Floo/RaspiDAC/Design/Frontplatte_5_Druckvorlage.pdf

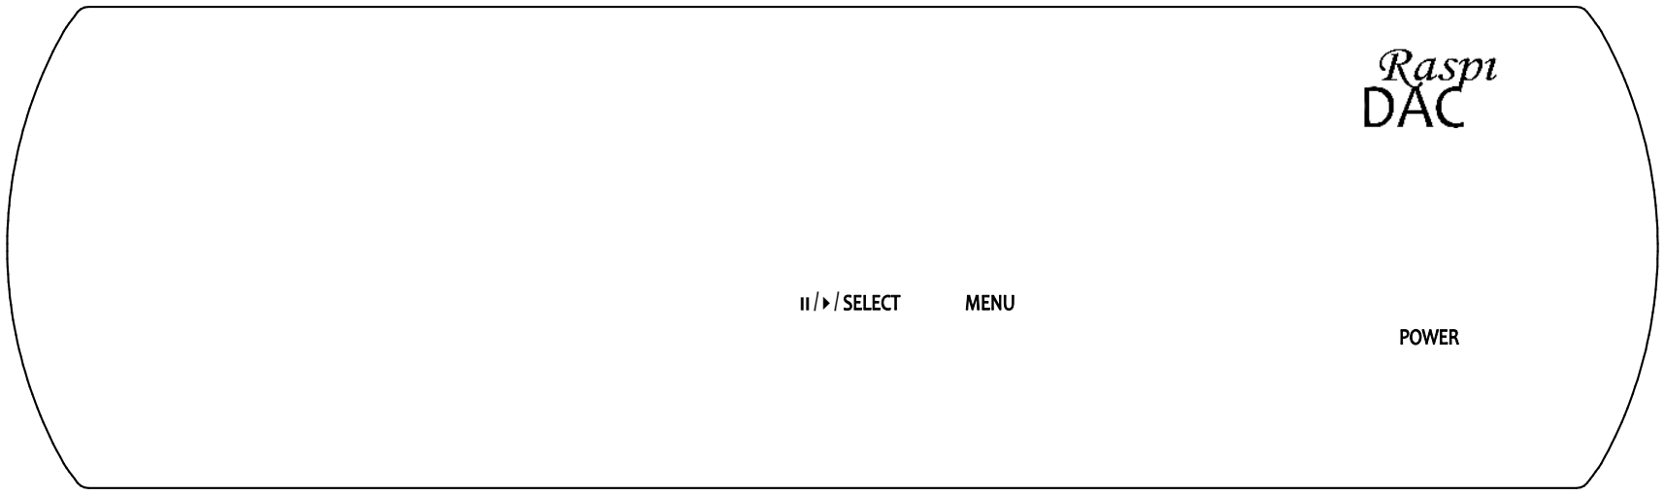
[picture p1: figure]
// SELECT; MENU; POWER
