Floo/RaspiDAC/Design/Rueckplatte_1_Druckvorlage.pdf

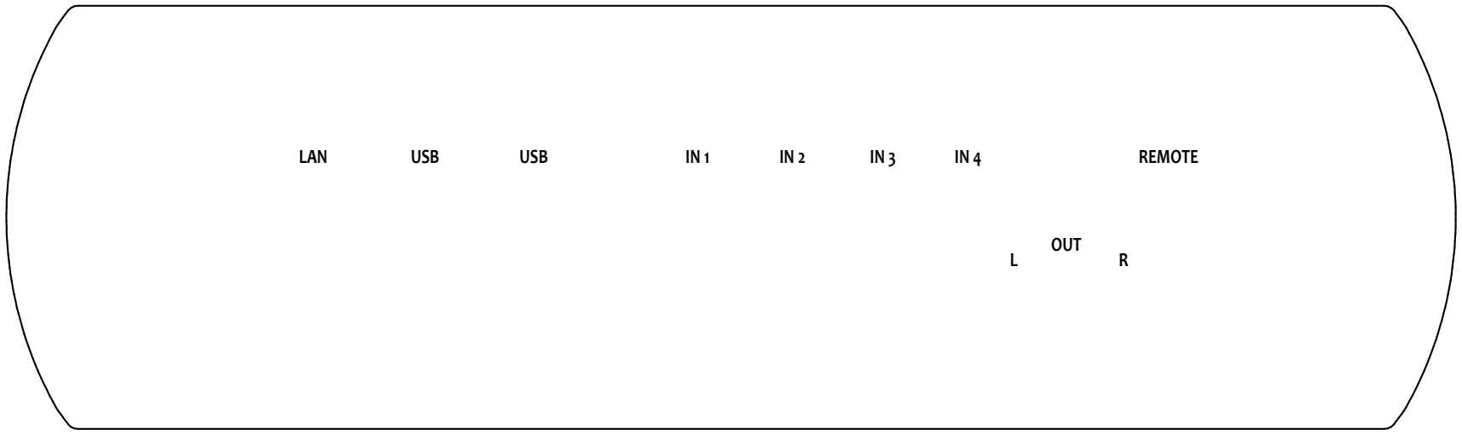
[picture p2: figure]
OUT; LAN; USB; REMOTE
