Floo/RaspiDAC/eagle/main_bom_v2.0.xlsx

Sheet: Tabelle1
Anzahl | Part | Value | Package | Lieferant | Best.-Nr. | Preis | Preis pro Einheit
4 | C11, C14, C19, C20 | 1n NP0 | 0805 | Segor | 1n0-0805-NP0 | 0.05 € | 0.20 €
7 | C5, C6, C10, C22, C23, C24, C25 | 10n | 0805 | Segor | 10n-0805-X7R | 0.05 € | 0.35 €
1 | C21 | 22n X7R | 0805 | Segor | 22n-0805-X7R | 0.05 € | 0.05 €
13 | C1, C2, C3, C7, C12, C15, C18, C26, C27, C28, C29, C30, C31 | 100n | 0805 | Segor | 100n-0805-X7R | 0.05 € | 0.65 €
4 | C9, C13, C16, C17 | 10µ | 3216 | Conrad | 458293 | 0.30 € | 1.20 €
2 | C4, C8 | 47µ/10V | 3528 | Conrad | 458307 (https://www.reichelt.de/Elkos-radial-105-C-1000-5000h/RAD-FC-10-50/3/index.html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) | 0.31 € | 0.62 €
2 | L1, L2 | 47µH | 1210 | Reichelt | LQH3C 47µ | 0.14 € | 0.28 €
1 | L3 | LPS4012-103 (10µH) |  | Coilcraft | Sample | 0.00 € | 0.00 €
3 | R20, R21, R22 | 1R | 0805 | Segor | 1R0-0805-1% | 0.04 € | 0.11 €
2 | R23, R24 | 75R | 0805 | Segor | 75R-0805-1% | 0.04 € | 0.08 €
3 | R7, R10, R11 | 100R | 0805 | Segor | 100R-0805-1% | 0.04 € | 0.11 €
1 | R19 | 3k | 0805 | Segor | 3k0-0805-1% | 0.04 € | 0.04 €
1 | R5 | 4k7 | 0805 | Segor | 4k7-0805-1% | 0.04 € | 0.04 €
14 | R1, R2, R12, R13, R14, R15, R16, R17, R25, R26, R27, R28, R29, R30 | 10k | 0805 | Segor | 10k-0805-1% | 0.04 € | 0.53 €
3 | R3, R8, R9 | 22k | 0805 | Segor | 22k-0805-1% | 0.04 € | 0.11 €
3 | R4, R6, R18 | 47k | 0805 | Segor | 47k-0805-1% | 0.04 € | 0.11 €
5 | T1, T3, T4, T5, T7 | BC847 | SOT23 | Reichelt | BC 847C SMD | 0.04 € | 0.20 €
2 | T2, T6 | BC857 | SOT23 | Reichelt | BC 857C SMD | 0.04 € | 0.08 €
2 | U1, U2 | DA101 |  | Segor | DA101C | 3.20 € | 6.40 €
3 | X3, X4, X5 | Cinch-Buchse |  | Conrad | 736899 | 1.47 € | 4.41 €
1 | IC1 | 74CBTLV3257 | SO-16 | vorhanden |  | 0.00 € | 0.00 €
1 | IC2 | PCA9530 | SO-8 | Reichelt | PCA 9530 D | 1.45 € | 1.45 €
1 | IC4 | CS8416 | SO-28 | Cirrus | Sample | 0.00 € | 0.00 €
1 | IC3 | RAC04-05SC/230 |  | Recom | Sample | 0.00 € | 0.00 €
1 | IC6 | MAX1836EUT33 | SOT23-6 | Maxim | Sample | 0.00 € | 0.00 €
1 | IC5 | MCP130-300 | SOT23 | Conrad | 1085790 | 0.65 € | 0.65 €
1 | K1 | G6A 5V |  | Conrad | 503801 | 4.20 € | 4.20 €
2 | OX1, OX2 | TORX1952 |  | vorhanden |  | 7.30 € | 14.60 €
6 | D1, D2, D3, D4, D5, D6 | BAS16 | SOT23 | Conrad | 162030 | 0.07 € | 0.42 €
1 | D7 | BAT165 | SOD323 | Conrad | 152958 | 0.21 € | 0.21 €
1 | F1 | MIK-TRÄGE 0,1A |  | Reichelt | MIK-TRÄGE 0,1A | 0.32 € | 0.32 € | höherer Wert wegen Einschaltstrom
2 |  | Pfostenverbinder RM2,54 2x13 |  | Conrad | 742185 | 0.56 € | 1.12 €
2 |  | Pfostenverbinder RM2,54 2x20 |  | Conrad | 742221 | 0.74 € | 1.48 €
1 |  | OS-0038N |  | Conrad | 184301 | 0.99 € | 0.99 €
 |  |  |  |  |  |  | 41.02 €

Sheet: main_bom
Part | Value | Device | Package | Description | MF MPN OC_FARNELL OC_NEWARK
C1 | 100n | C-EUC0805 | C0805 | CAPACITOR, European symbol
C2 | 100n | C-EUC0805 | C0805 | CAPACITOR, European symbol
C3 | 100n | C-EUC0805 | C0805 | CAPACITOR, European symbol
C4 | 47µ | CPOL-EUE2-4 | E2-4 | POLARIZED CAPACITOR, European | symbol
C5 | 10n | C-EUC0805 | C0805 | CAPACITOR, European symbol
C6 | 10n | C-EUC0805 | C0805 | CAPACITOR, European symbol
C7 | 100n | C-EUC0805 | C0805 | CAPACITOR, European symbol
C8 | 100µ | CPOL-EUE2-4 | E2-4 | POLARIZED CAPACITOR, European | symbol
C9 | 10µ | CPOL-EUE2-4 | E2-4 | POLARIZED CAPACITOR, European | symbol
C10 | 10n | C-EUC0805 | C0805 | CAPACITOR, European symbol
C11 | 1n | C-EUC0805 | C0805 | CAPACITOR, European symbol
C12 | 100n | C-EUC0805 | C0805 | CAPACITOR, European symbol
C13 | 10µ | CPOL-EUE2-4 | E2-4 | POLARIZED CAPACITOR, European | symbol
C14 | 1n | C-EUC0805 | C0805 | CAPACITOR, European symbol
C15 | 100n | C-EUC0805 | C0805 | CAPACITOR, European symbol
C16 | 10µ | CPOL-EUE2-4 | E2-4 | POLARIZED CAPACITOR, European | symbol
C17 | 10µ | CPOL-EUE2-4 | E2-4 | POLARIZED CAPACITOR, European | symbol
C18 | 100n | C-EUC0805 | C0805 | CAPACITOR, European symbol
C19 | 1n | C-EUC0805 | C0805 | CAPACITOR, European symbol
C20 | 1n | C-EUC0805 | C0805 | CAPACITOR, European symbol
C21 | 22n | C-EUC0805 | C0805 | CAPACITOR, European symbol
C22 | 10n | C-EUC0805 | C0805 | CAPACITOR, European symbol
C23 | 10n | C-EUC0805 | C0805 | CAPACITOR, European symbol
C24 | 10n | C-EUC0805 | C0805 | CAPACITOR, European symbol
C25 | 10n | C-EUC0805 | C0805 | CAPACITOR, European symbol
C26 | 100n | C-EUC0805 | C0805 | CAPACITOR, European symbol
C27 | 100n | C-EUC0805 | C0805 | CAPACITOR, European symbol
C28 | 100n | C-EUC0805 | C0805 | CAPACITOR, European symbol
C29 | 100n | C-EUC0805 | C0805 | CAPACITOR, European symbol
C30 | 100n | C-EUC0805 | C0805 | CAPACITOR, European symbol
CON1 |  | CON40 | CON40 | CONNECTOR | unknown unknown
CON2 |  | CON26 | CON26 | CONNECTOR | unknown unknown
D1 | BAS40 | BAS40 | SOT23 | Silicon Schottky Diodes
D2 | BAS40 | BAS40 | SOT23 | Silicon Schottky Diodes
D3 | BAS40 | BAS40 | SOT23 | Silicon Schottky Diodes
D4 | BAS40 | BAS40 | SOT23 | Silicon Schottky Diodes
D5 | BAS40 | BAS40 | SOT23 | Silicon Schottky Diodes
F1 |  | 19560 | 19560 | FUSE HOLDER | 56000001009 1185363 15P8392
IC1 | 74HC2 | 57D 74HC257D | SO16 | Quadruple 2-to 1 line data SE | LECTOR/MULTIPLEXER
IC2 | PCA95 | 30 PCA9530 | SOIC-8
IC3 | RAC04 | RAC04 | RECOM-RAC04
IC4 | CS841 | 6-SOFTWAREMODESOFTWAREMODE CS8416-SOFTWAREMODESOFTWAREMODE | SO28L | 24bit 192kHz Digital Audio In | terface Receiver - Software Mode
IC5 | MCP13 | 0-300I/SN MCP130-300I/SN | SOT-23
IC6 | REG11 | 17 REG1117 | SOT223 | 800mA and 1A Low Dropout (LDO | ) Positive Regulator REG1117 1097566 14P6981
JP1 |  | PINHD-2X3 | 2X03 | PIN HEADER
JP2 |  | PINHD-2X3 | 2X03 | PIN HEADER
JP3 |  | PINHD-2X3 | 2X03 | PIN HEADER
JP4 |  | JP1Q | JP1 | JUMPER
K1 | G6A-2 | 34P G6A-234P | G6A-234P | RELAY | unknown unknown
L1 | 47µ | L-EU | C1210 | INDUCTOR, European symbol
L2 | 47µ | L-EU | C1210 | INDUCTOR, European symbol
OX1 | TORX1 | 73 TORX173 | TORX173 | FIBER OPTIC RECEIVING MODULE | unknown unknown
OX2 | TORX1 | 73 TORX173 | TORX173 | FIBER OPTIC RECEIVING MODULE | unknown unknown
R1 | 10k | R-EU_R0805 | R0805 | RESISTOR, European symbol
R2 | 10k | R-EU_R0805 | R0805 | RESISTOR, European symbol
R3 | 22k | R-EU_R0805 | R0805 | RESISTOR, European symbol
R4 | 47k | R-EU_R0805 | R0805 | RESISTOR, European symbol
R5 | 4k7 | R-EU_R0805 | R0805 | RESISTOR, European symbol
R6 | 47k | R-EU_R0805 | R0805 | RESISTOR, European symbol
R7 | 100R | R-EU_R0805 | R0805 | RESISTOR, European symbol
R8 | 22k | R-EU_R0805 | R0805 | RESISTOR, European symbol
R9 | 22k | R-EU_R0805 | R0805 | RESISTOR, European symbol
R10 | 100R | R-EU_R0805 | R0805 | RESISTOR, European symbol
R11 | 100R | R-EU_R0805 | R0805 | RESISTOR, European symbol
R12 | 10k | R-EU_R0805 | R0805 | RESISTOR, European symbol
R13 | 10k | R-EU_R0805 | R0805 | RESISTOR, European symbol
R14 | 10k | R-EU_R0805 | R0805 | RESISTOR, European symbol
R15 | 10k | R-EU_R0805 | R0805 | RESISTOR, European symbol
R16 | 10k | R-EU_R0805 | R0805 | RESISTOR, European symbol
R17 | 10k | R-EU_R0805 | R0805 | RESISTOR, European symbol
R18 | 47k | R-EU_R0805 | R0805 | RESISTOR, European symbol
R19 | 3k | R-EU_R0805 | R0805 | RESISTOR, European symbol
R20 | 1R | R-EU_R0805 | R0805 | RESISTOR, European symbol
R21 | 1R | R-EU_R0805 | R0805 | RESISTOR, European symbol
R22 | 1R | R-EU_R0805 | R0805 | RESISTOR, European symbol
R23 | 75R | R-EU_R0805 | R0805 | RESISTOR, European symbol
R24 | 75R | R-EU_R0805 | R0805 | RESISTOR, European symbol
R25 | 10k | R-EU_R0805 | R0805 | RESISTOR, European symbol
R26 | 10k | R-EU_R0805 | R0805 | RESISTOR, European symbol
R27 | 10k | R-EU_R0805 | R0805 | RESISTOR, European symbol
T1 | BC847 | BC847-NPN-SOT23-BEC | SOT23-BEC | NPN Transistror
T2 | BC857 | BC857A-PNP-SOT23-BEC | SOT23-BEC | PNP Transistror
T3 | BC847 | BC847-NPN-SOT23-BEC | SOT23-BEC | NPN Transistror
T4 | BC847 | BC847-NPN-SOT23-BEC | SOT23-BEC | NPN Transistror
T5 | BC847 | BC847-NPN-SOT23-BEC | SOT23-BEC | NPN Transistror
U$1 | DA101 | DA101 | 6PIN-DIL
U$2 | DA101 | DA101 | 6PIN-DIL
X1 |  | 2POL500 | 2POL500 | PHOENIX CONNECTOR | unknown unknown
X2 |  | 2POL500 | 2POL500 | PHOENIX CONNECTOR | unknown unknown
X3 | WBTOR | 1 WBTOR1 | WBTOR1 | RCA connectors according to J | EITA RC-5231 Cinch WBTOR 1 BLACK 1200146 98K2588
X4 | WBTOR | 1 WBTOR1 | WBTOR1 | RCA connectors according to J | EITA RC-5231 Cinch WBTOR 1 BLACK 1200146 98K2588
X5 | WBTOR | 1 WBTOR1 | WBTOR1 | RCA connectors according to J | EITA RC-5231 Cinch WBTOR 1 BLACK 1200146 98K2588
