Floo/RaspiDAC/Design/Frontplatte_5_bemasst.DXF

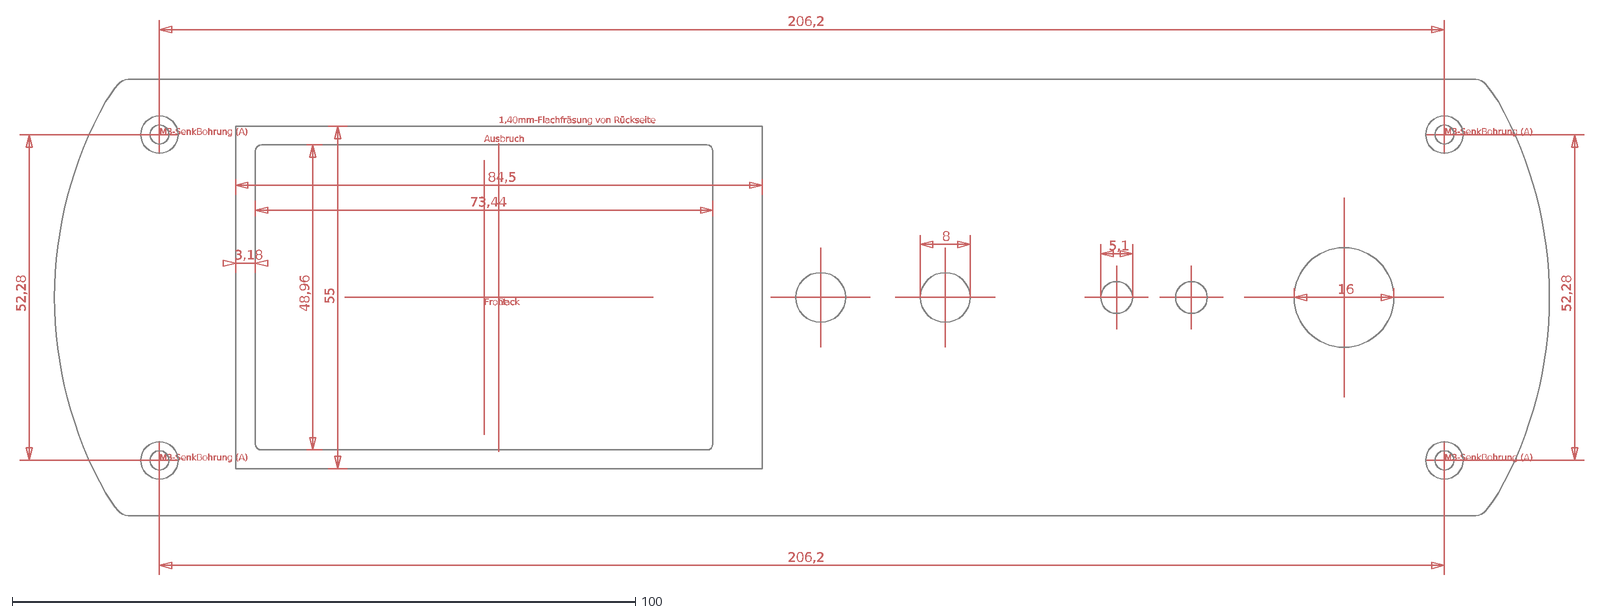
[picture p3: CAD file, 2015-07-29]
Design/Frontplatte_5_bemasst.DXF
M3-SenkBohrung (A)
Ausbruch
Front
1,40mm-Flachfräsung von Rückseite
Back
52,28
206,2
48,96
55
84,5
73,44
3,18
5,1
8
16
