Floo/RaspiDAC/Design/Frontplatte_5.DXF

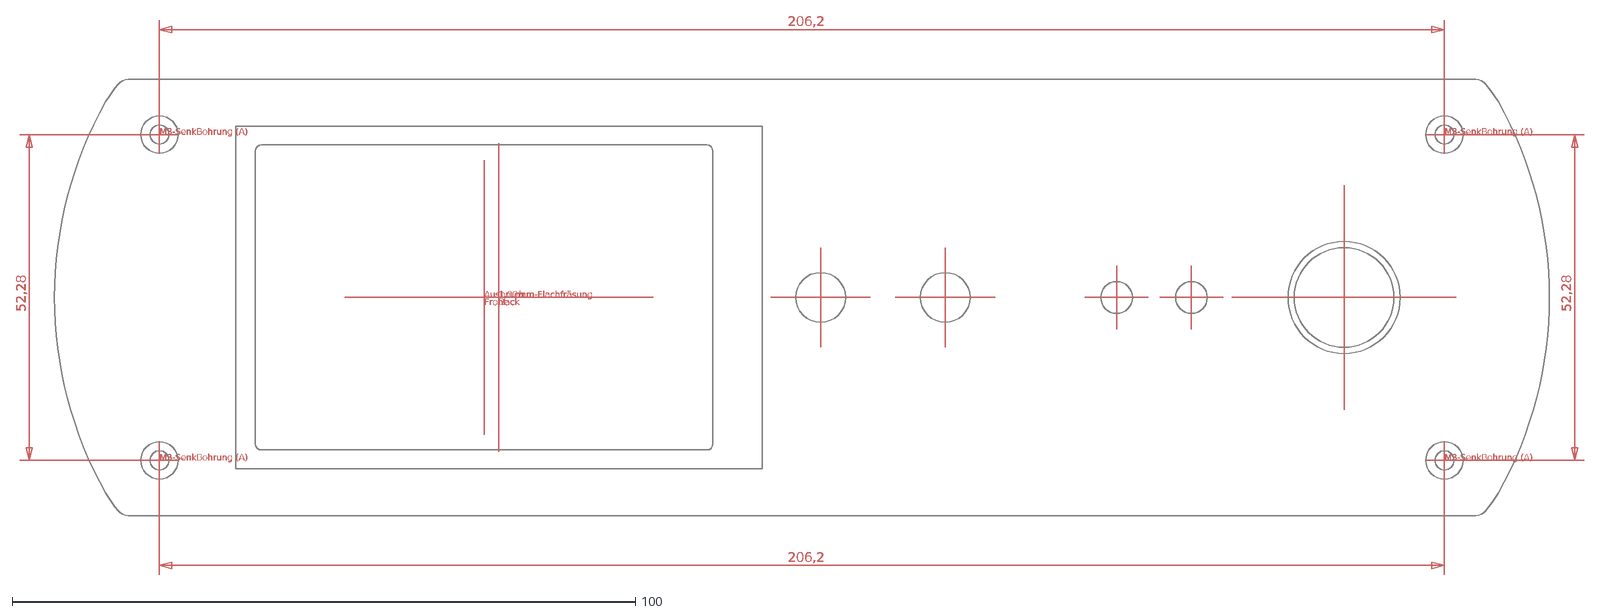
[picture p4: CAD file, 2015-07-15]
Design/Frontplatte_5.DXF
M3-SenkBohrung (A)
Ausbruch
Front
1,00mm-Flachfräsung
Back
52,28
206,2
