Floo/RaspiDAC/(list of files, cad)

Other CAD files:
Design/Rueckplatte_1.DXF
