Floo/RaspiDAC/eagle/Schematics_v1.0.pdf

# D2 D³

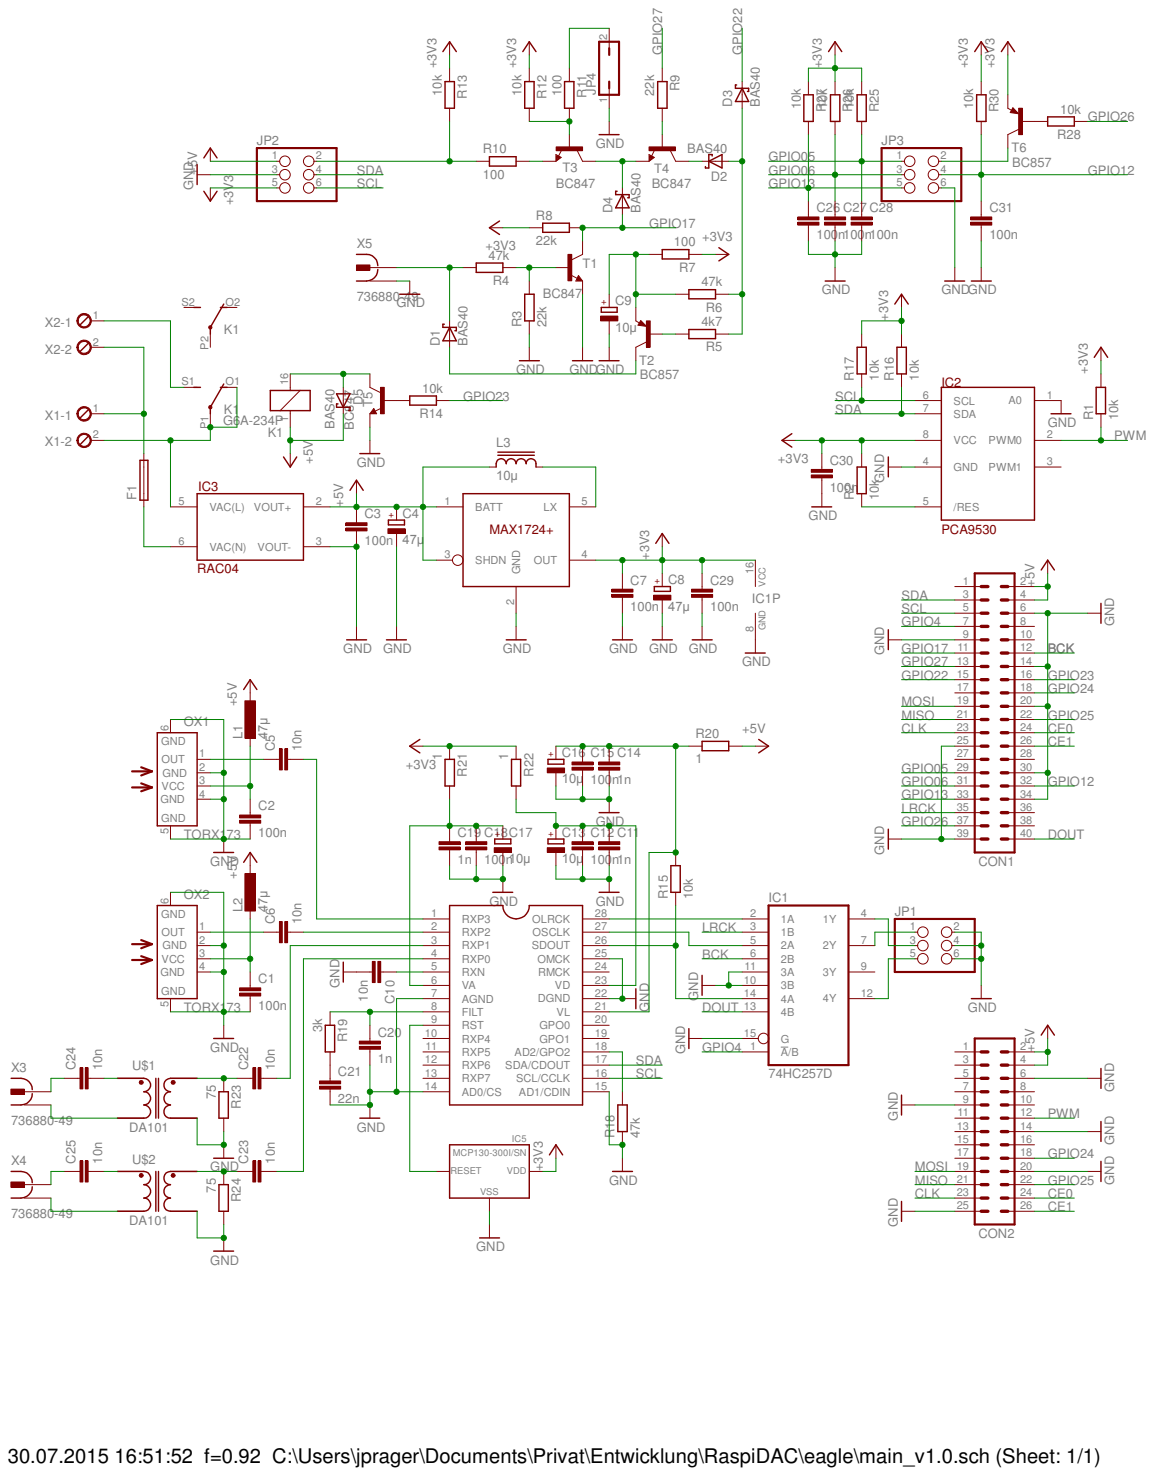
[picture p5: page 1]

3 4 | SDA | | GPIO06 | | | 3 4 6
5 6 | SCL | | GPIO13 | | | 5

30.07.2015 16:51:52 f=0.92 C:\Users\jprager\Documents\Privat\Entwicklung\RaspiDAC\eagle\main_v1.0.sch (Sheet: 1/1)
