Floo/RaspiDAC/eagle/Bestueckung_v1.0.pdf

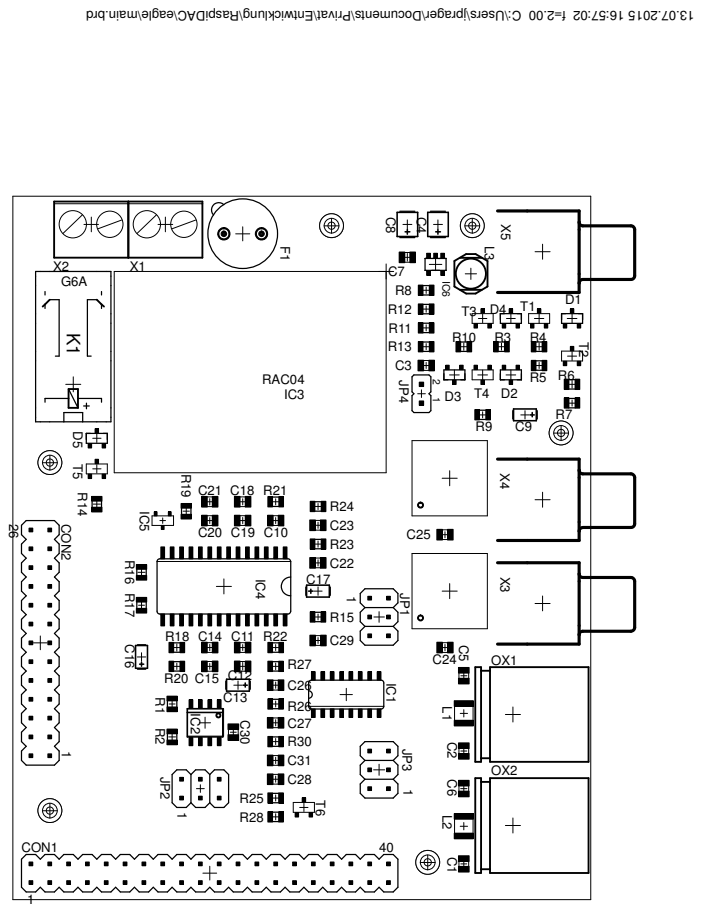
[picture p6: page 1]
