Floo/RaspiDAC/eagle/Bestueckung_Werte_v1.0.pdf

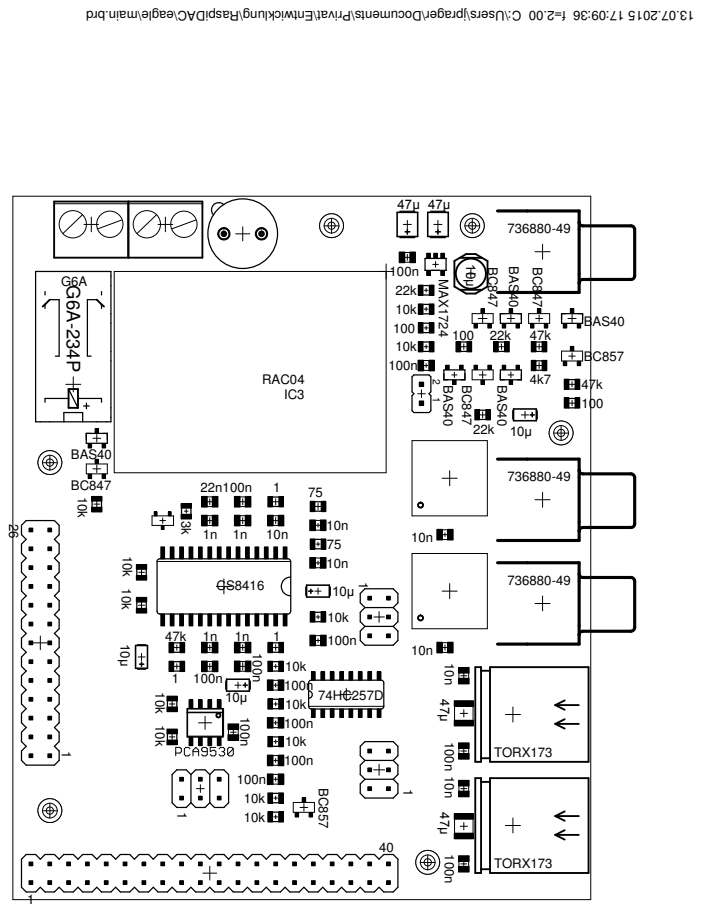
[picture p7: page 1]
RAC04; BAS40; TORX173; 47k³k; MAX1724
