Floo/RaspiDAC/simulation/InfraRed.asc

D5: schottky; 1N5817
D6: schottky; 1N5817
D7: schottky; 1N5817
D8: schottky; 1N5818
Q1: npn
Q2: npn
Q3: npn
Q4: pnp
Q5: npn
Q6: npn
Q7: npn
Q8: pnp
Q9: pnp
Q10: pnp
Q11: pnp
Q12: npn
R1: EuropeanResistor; 10k
R2: EuropeanResistor; 10k
R3: EuropeanResistor; 100
R4: EuropeanResistor; 22k
R5: EuropeanResistor; 22k
R6: EuropeanResistor; 100
R7: EuropeanResistor; 47k
R8: EuropeanResistor; 100
R9: EuropeanResistor; 4k7
R10: EuropeanResistor; 47k
R11: EuropeanResistor; 22k
R12: EuropeanResistor; 22k
R13: EuropeanResistor; 22k
R14: EuropeanResistor; 10k
R15: EuropeanResistor; 10k
R16: EuropeanResistor; 10k
R17: EuropeanResistor; 47k
R18: EuropeanResistor; 22k
R19: EuropeanResistor; 10k
R20: EuropeanResistor; 10k
R21: EuropeanResistor; 10k
R22: EuropeanResistor; 10k
R23: EuropeanResistor; 10k
R24: EuropeanResistor; 10k
R25: EuropeanResistor; 10k
R26: EuropeanResistor; 10k
V1: voltage; 3.3
V2: voltage; PULSE(0 3.3 0 0 0 0.0005 0.0015 0)
V3: voltage; 5
V4: voltage; PULSE(0 0 0 0 0 0.0003 0.0008 0)
Named nets: 0, 3V, 17, IR_1, REMOTE, 5V, ENTX, REMOTE_IN, IR_2, RXRC, TXRC
.tran 0 0.01 0 0.0001
PM8000
RaspiDAC
IR_DIRECT
(GPIO27)
TX (GPIO22)
RX (GPIO17)
