Floo/RaspiDAC/eagle/Netzteil_5V.brd

## EAGLE design eagle/Netzteil_5V.brd (2016-04-11)

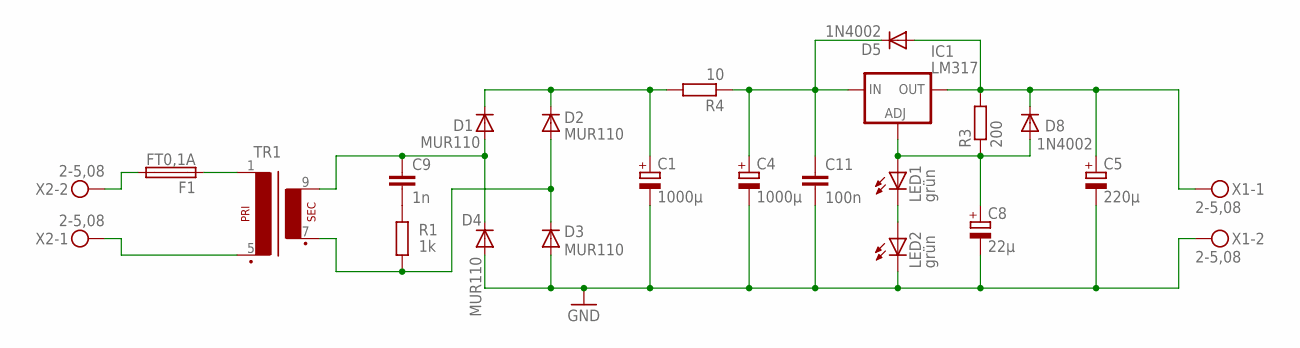
[picture p8: schematic Netzteil_5V.sch]

Parts:
C1, C4: 1000µ; E5-13
C5: 220µ; E3,5-8
C8: 22µ; E2-5
C9: 1n; C050-045X075
C11: 100n; C050-025X075
D1, D2, D3, D4: MUR110; DO41-10
D5, D8: 1N4002; DO41-10
F1: FT0,1A; 19560
IC1: LM317; 317TS
LED1, LED2: grün; LED3MM
R1: 1k; 0207/10
R3: 200; 0207/10
R4: 10; 0617V
TR1: EI38-1
X1, X2: 2-5,08; MKDSN1,5/2-5,08

Connections:
GND: C1.-, C4.-, C5.-, C8.-, C11.2, D3.A, D4.A, LED2.K (C), X1.2
unnamed: F1.2, X2.2
unnamed: F1.1, TR1.1
unnamed: TR1.5 (P2), X2.1
unnamed: LED1.K (C), LED2.A
unnamed: C9.2, R1.2
unnamed: C9.1, D1.A, D4.C, TR1.9 (S4)
unnamed: D2.A, D3.C, R1.1, TR1.7 (S3)
unnamed: C1.+, D1.C, D2.C, R4.2
unnamed: C4.+, C11.1, D5.C, IC1.3 (IN), R4.1
unnamed: C8.+, D8.A, IC1.1 (ADJ), LED1.A, R3.1
unnamed: C5.+, D5.A, D8.C, IC1.2 (OUT), R3.2, X1.1

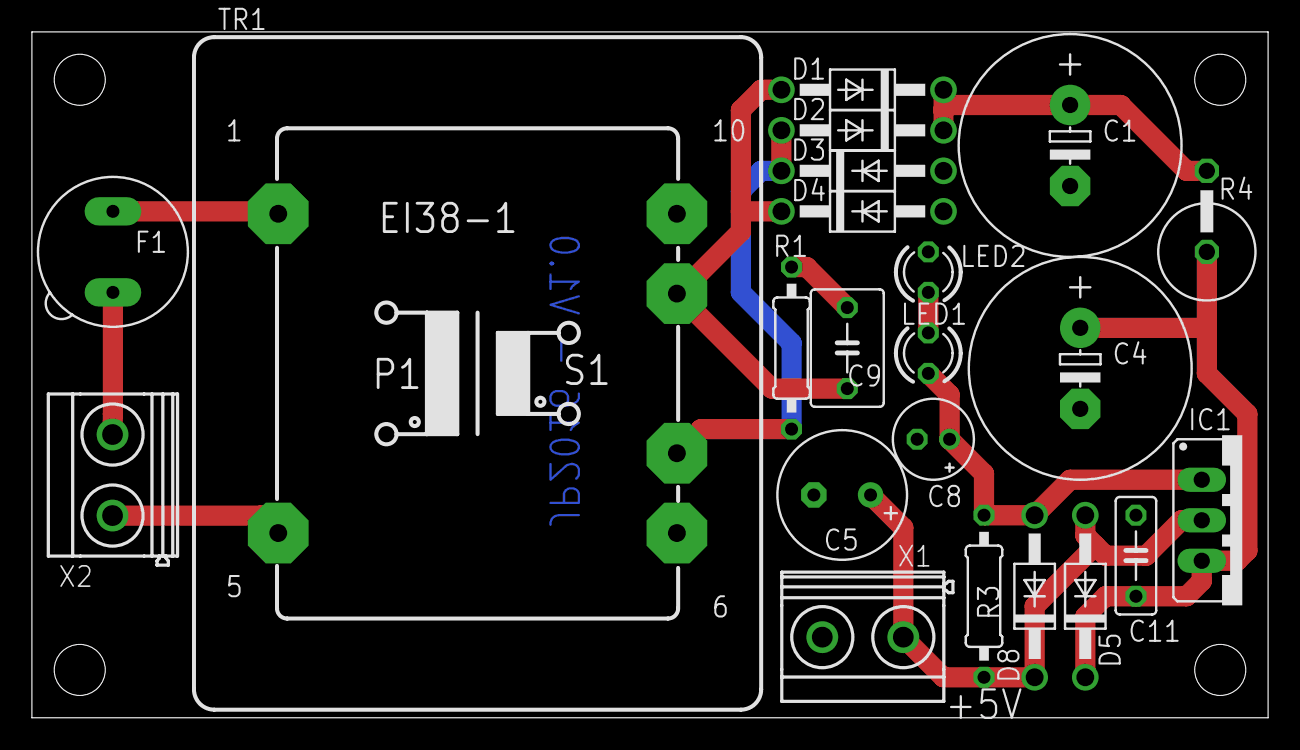
[picture p9: board Netzteil_5V.brd from above]

Board: 2 copper layers, 77.5 x 43.0 mm, 22 parts (0 on the bottom side), 12 nets.
