Floo/RaspiDAC/eagle/main_v2.0.brd

## EAGLE design eagle/main_v2.0.brd (2016-04-11)

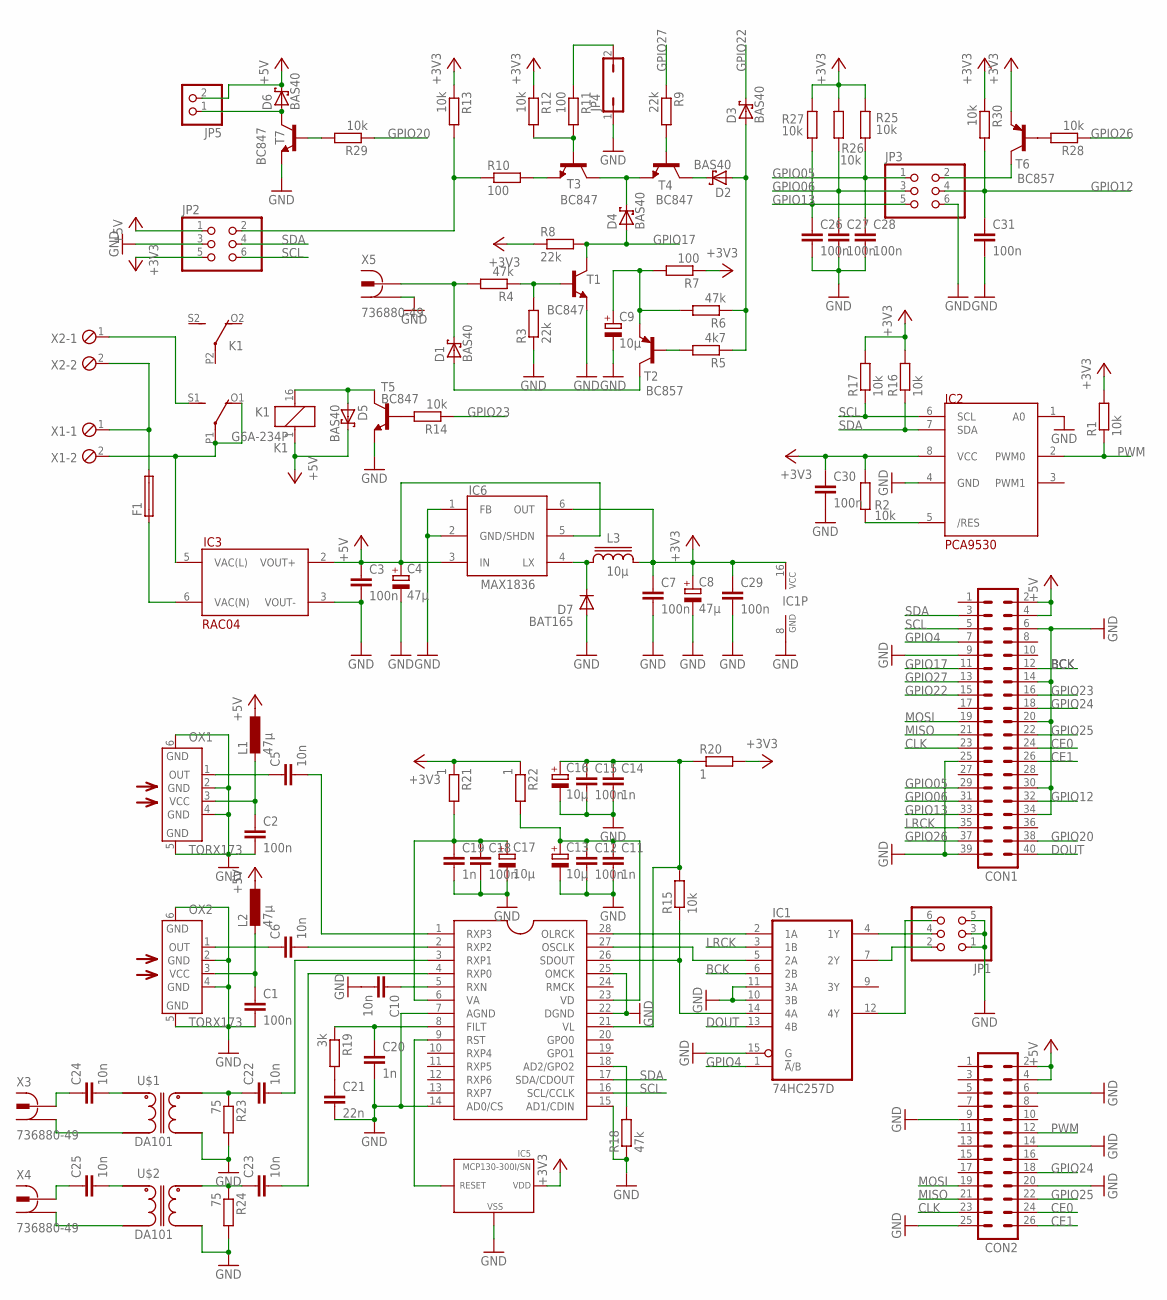
[picture p10: schematic main_v2.0.sch]

Parts:
C1, C2, C3, C7, C12, C15, C18, C26, C27, C28, C29, C30, C31: 100n; C0805
C4, C8: 47µ; CT3528
C5, C6, C10, C22, C23, C24, C25: 10n; C0805
C9, C13, C16, C17: 10µ; CT3216
C11, C14, C19, C20: 1n; C0805
C21: 22n; C0805
CON1: MA20-2
CON2: MA13-2
D1, D2, D3, D4, D5, D6: BAS40; SOT23
D7: BAT165; SOD-323F
F1: 19560
IC1: 74HC257D; SO16
IC2: PCA9530; SOIC-8
IC3: RAC04; RECOM-RAC04
IC4: CS8416; SO28L
IC5: MCP130-300I/SN; SOT-23
IC6: MAX1836; SOT23-6L
JP1, JP2, JP3: PINHD-2X3; 2X03
JP4: JP1Q; JP1
JP5: PINHD-1X2; 1X02
K1: G6A-234P
L1, L2: 47µ; C1210
L3: 10µ; LPS4018
OX1, OX2: TORX173
R1, R2, R12, R13, R14, R15, R16, R17, R25, R26, R27, R28, R29, R30: 10k; R0805
R3, R8, R9: 22k; R0805
R4, R6, R18: 47k; R0805
R5: 4k7; R0805
R7, R10, R11: 100; R0805
R19: 3k; R0805
R20, R21, R22: 1; R0805
R23, R24: 75; R0805
T1, T3, T4, T5, T7: BC847; SOT23-BEC
T2, T6: BC857; SOT23-BEC
U$1, U$2: DA101; 6PIN-DIL
X1, X2: 2POL500
X3, X4, X5: 736880-49

Connections:
+3V3: C7.1, C8.+, C29.1, C30.1, IC1.16 (VCC), IC2.8 (VCC), IC5.2 (VDD), IC6.6 (OUT), JP2.5, L3.2, R1.2, R2.2, R7.1, R8.1, R12.1, R13.1, R16.2, R17.2, R20.2, R21.1, R22.1, R25.1, R26.1, R27.1, R30.1, T6.E
+5V: C3.1, C4.+, CON1.2, CON1.4, CON2.2, CON2.4, D5.3 (C), D6.3 (C), IC3.2 (VOUT+), IC6.3 (IN), IC6.5 (/SHDN), JP2.1, JP5.2, K1.1, L1.1, L2.1
BCK: CON1.12, IC1.6 (2B)
CE0: CON1.24, CON2.24
CE1: CON1.26, CON2.26
CLK: CON1.23, CON2.23
DOUT: CON1.40, IC1.13 (4B)
GND: C1.2, C2.2, C3.2, C4.-, C7.2, C8.-, C9.-, C10.2, C11.2, C12.2, C13.-, C14.2, C15.2, C16.-, C17.-, C18.2, C19.2, C20.2, C21.2, C26.2, C27.2, C28.2, C29.2, C30.2, C31.2, CON1.6, CON1.9, CON1.14, CON1.20, CON1.25, CON1.30, CON1.34, CON1.39, CON2.6, CON2.9, CON2.14, CON2.20, CON2.25, D7.A, IC1.8 (GND), IC1.10 (3B), IC1.11 (3A), IC1.15 (G), IC2.1 (A0), IC2.4 (GND), IC3.3 (VOUT-), IC4.7 (AGND), IC4.14 (AD0/CS), IC4.15 (AD1/CDIN), IC4.22 (DGND), IC4.25 (OMCK), IC5.3 (VSS), IC6.1 (FB), IC6.2 (GND), JP1.1, JP1.3, JP1.5, JP2.3, JP3.6, JP4.1, OX1.2 (GND), OX1.4 (GND), OX1.5 (GND), OX1.6 (GND), OX2.2 (GND), OX2.4 (GND), OX2.5 (GND), OX2.6 (GND), R3.1, R18.1, R23.2, R24.2, T1.E, T5.E, T7.E, U$1.4, U$2.4, X5.1, X5.1@1 (1), X5.1@2 (1)
GPIO4: CON1.7, IC1.1 (!A!/B)
GPIO05: C28.1, CON1.29, JP3.1, R25.2
GPIO06: C27.1, CON1.31, JP3.3, R26.2
GPIO12: C31.1, CON1.32, JP3.4, R30.2
GPIO13: C26.1, CON1.33, JP3.5, R27.2
GPIO17: CON1.11, D4.1 (A), R8.2, T1.C
GPIO20: CON1.38, R29.1
GPIO22: CON1.15, D3.3 (C)
GPIO23: CON1.16, R14.1
GPIO24: CON1.18, CON2.18
GPIO25: CON1.22, CON2.22
GPIO26: CON1.37, R28.1
GPIO27: CON1.13, R9.1
LRCK: CON1.35, IC1.3 (1B)
MISO: CON1.21, CON2.21
MOSI: CON1.19, CON2.19
unnamed: C11.1, C12.1, C13.+, IC4.23 (VD), R22.2
unnamed: IC1.2 (1A), IC4.28 (OLRCK)
unnamed: IC1.5 (2A), IC4.27 (OSCLK)
unnamed: IC1.14 (4A), IC4.26 (SDOUT), R15.1
unnamed: IC4.9 (RST), IC5.1 (RESET)
unnamed: IC2.5 (/RES), R2.1
unnamed: F1.1, IC3.6 (VAC(N))
unnamed: C17.+, C18.1, C19.1, IC4.6 (VA), R21.2
unnamed: C6.1, OX2.1 (OUT)
unnamed: C5.1, OX1.1 (OUT)
unnamed: C6.2, IC4.2 (RXP2)
unnamed: C5.2, IC4.1 (RXP3)
unnamed: IC3.5 (VAC(L)), K1.O1 (O), K1.P1, X1.2
unnamed: R3.2, R4.1, T1.B
unnamed: JP4.2, R11.1
unnamed: D1.1 (A), T2.C
unnamed: D1.3 (C), R4.2, X5.2
unnamed: C9.+, R6.2, R7.2, T2.E
unnamed: R5.2, T2.B
unnamed: D2.1 (A), D3.1 (A), R5.1, R6.1
unnamed: D4.3 (C), T3.C, T4.E
unnamed: R10.2, T3.E
unnamed: R11.2, R12.2, T3.B
unnamed: R9.2, T4.B
unnamed: D2.3 (C), T4.C
unnamed: IC1.7 (2Y), JP1.2
unnamed: IC1.4 (1Y), JP1.4
unnamed: D7.C, IC6.4 (LX), L3.1
unnamed: JP2.2, R10.1, R13.2
unnamed: C10.1, IC4.5 (RXN)
unnamed: IC4.18 (AD2/GPO2), R18.2
unnamed: C14.1, C15.1, C16.+, IC4.21 (VL), R15.2, R20.1
unnamed: D5.1 (A), K1.16 (2), T5.C
unnamed: R14.2, T5.B
unnamed: C22.1, R23.1, U$1.6
unnamed: C20.1, IC4.8 (FILT), R19.1
unnamed: C21.1, R19.2
unnamed: C22.2, IC4.3 (RXP1)
unnamed: C23.2, IC4.4 (RXP0)
unnamed: C23.1, R24.1, U$2.6
unnamed: C24.2, U$1.1
unnamed: U$1.3, X3.1, X3.1@1 (1), X3.1@2 (1)
unnamed: C24.1, X3.2
unnamed: C25.2, U$2.1
unnamed: U$2.3, X4.1, X4.1@1 (1), X4.1@2 (1)
unnamed: C25.1, X4.2
unnamed: R28.2, T6.B
unnamed: K1.S1 (S), X2.1
unnamed: F1.2, X1.1, X2.2
unnamed: C2.1, L1.2, OX1.3 (VCC)
unnamed: C1.1, L2.2, OX2.3 (VCC)
unnamed: D6.1 (A), JP5.1, T7.C
unnamed: IC1.12 (4Y), JP1.6
unnamed: JP3.2, T6.C
unnamed: R29.2, T7.B
PWM: CON2.12, IC2.2 (PWM0), R1.1
SCL: CON1.5, IC2.6 (SCL), IC4.16 (SCL/CCLK), JP2.6, R17.1
SDA: CON1.3, IC2.7 (SDA), IC4.17 (SDA/CDOUT), JP2.4, R16.1

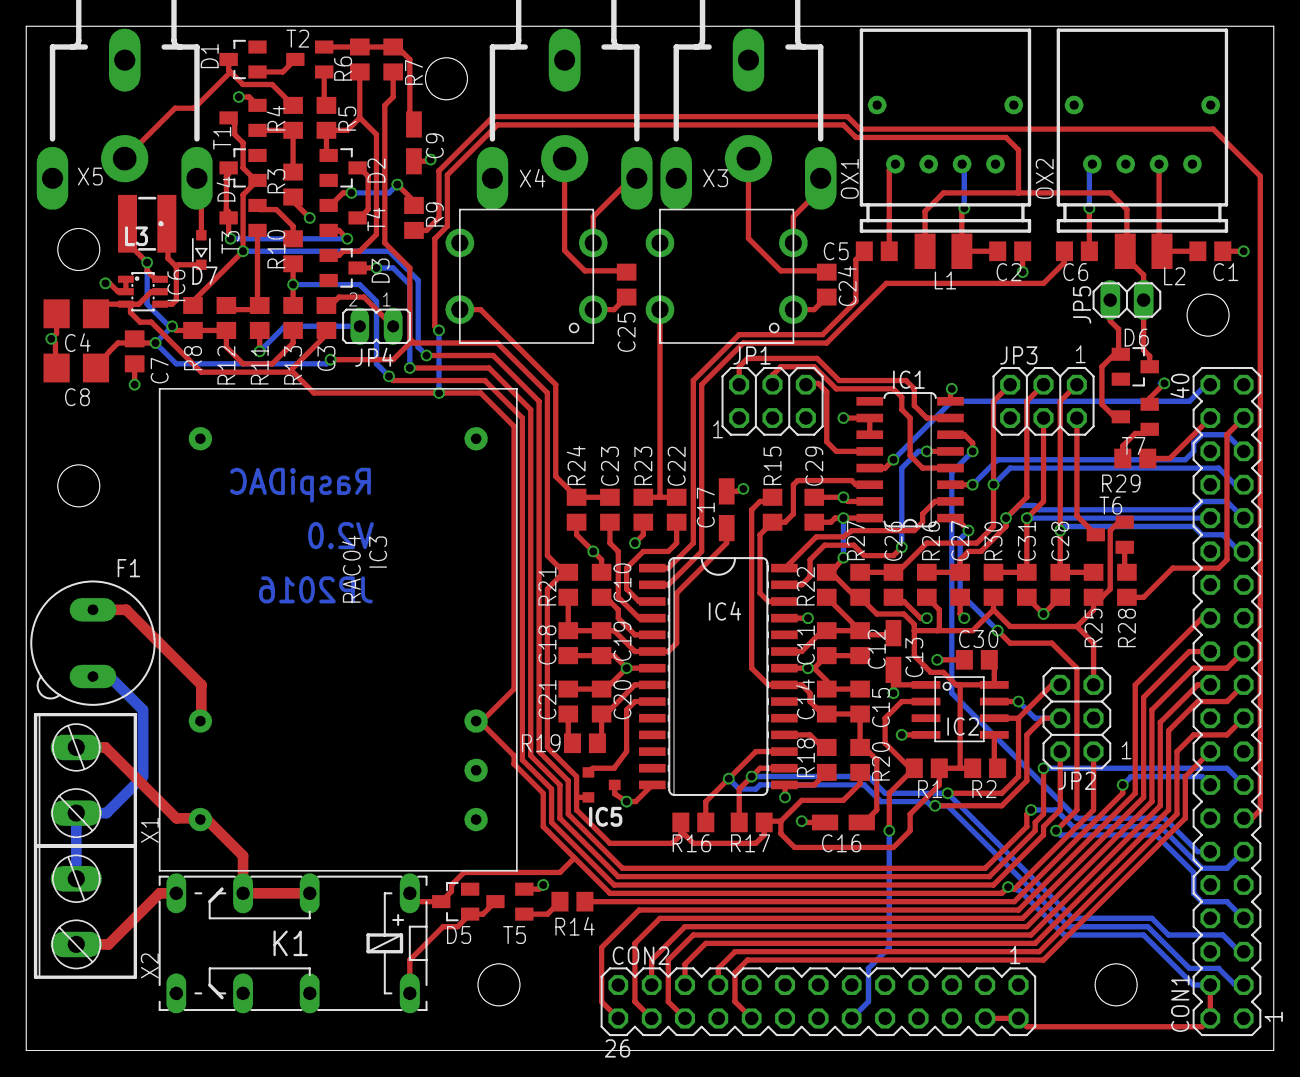
[picture p11: board main_v2.0.brd from above]

Board: 2 copper layers, 95.0 x 78.0 mm, 102 parts (0 on the bottom side), 82 nets.
