Floo/RaspiDAC/(commit log)

2015-07-15 Projekt neu zusammengestellt mit Bezug auf upstream Repository
    [Frontplatte_5.DXF, main.brd, main.sch, main_bom.xlsx]
2015-07-17 Eaegle-Files mit Versionsnummern versehen und Version 2.0 hinzugefügt
    [main_bom.xlsx, main_v1.0.brd, main_v1.0.sch, main_v2.0.brd, main_v2.0.sch]
2015-07-17 Frontplatte überprüft und bemaßt
    [Frontplatte_5_bemasst.DXF]
2015-07-31 Add Schematics_v1.0.pdf
2015-11-16 Rückplatte designed
    [Rueckplatte_1.DXF]
2016-01-26 neues Interface zu upplay, OHRadio wird verwendet
2016-02-03 GUI und Menu eingebaut
2016-02-09 Erzeugung der RadioList ohne zusätzliches SIGNAL in application.cpp
2016-02-15 Ticker und AlbumArt verbessert
2016-02-23 Eagle-Files: V2.0, zusätzlichen Ausgang für Relais eingebaut
    [main_v2.0.brd, main_v2.0.sch]
2016-02-29 Umstellung auf Subtree-Projekt - Feinschliff und upplay.cpp umbenannt in RaspiDAC.cpp
2016-03-07 Eagle V2.0: 3.3V Step-Down-Wandler ersetzt und Fehler behoben. Keine weiteren Anpassungen mehr nötig.
    [main_bom_v1.0.xlsx, main_bom_v2.0.xlsx, main_v2.0.brd, main_v2.0.sch]
2016-03-09 LIRC läuft, Senden und Empfangen
2016-03-10 Simulation des IR-Interface
2016-03-10 Entwurf Konfiguration in CSettingStorage Entwurf I2C für Lichtsensor
2016-03-11 Repeat für LircSend eingefügt und unterschiedliche PULSE_LENGTH und SPACE_LENGTH
2016-03-11 Sytaxfehler behoben, noch nicht getestet
    [raspidac.cpp, rpigpio.cpp, rpigpio.h]
2016-04-11 Eagle Netzteilplatinen erstellt
    [Netzteil_15V.brd, Netzteil_15V.sch, Netzteil_5V.brd, Netzteil_5V.sch]
2016-04-11 Feinschliff Eagle Daten
    [Netzteil_15V.brd, Netzteil_5V.brd, main_v2.0.brd]
2016-04-12 Helligkeitssteuerung und Änderungen an der Oberfläche
